Finomnis/GenericHardware/README.md

# GenericHardware
Generic Hardware Projects that didn't fit in anywhere else and were too small to get their own repository.
