Finomnis/GenericHardware/devboard-stm32g030f6p6/release/v1/devboard-stm32g030f6p6.pdf

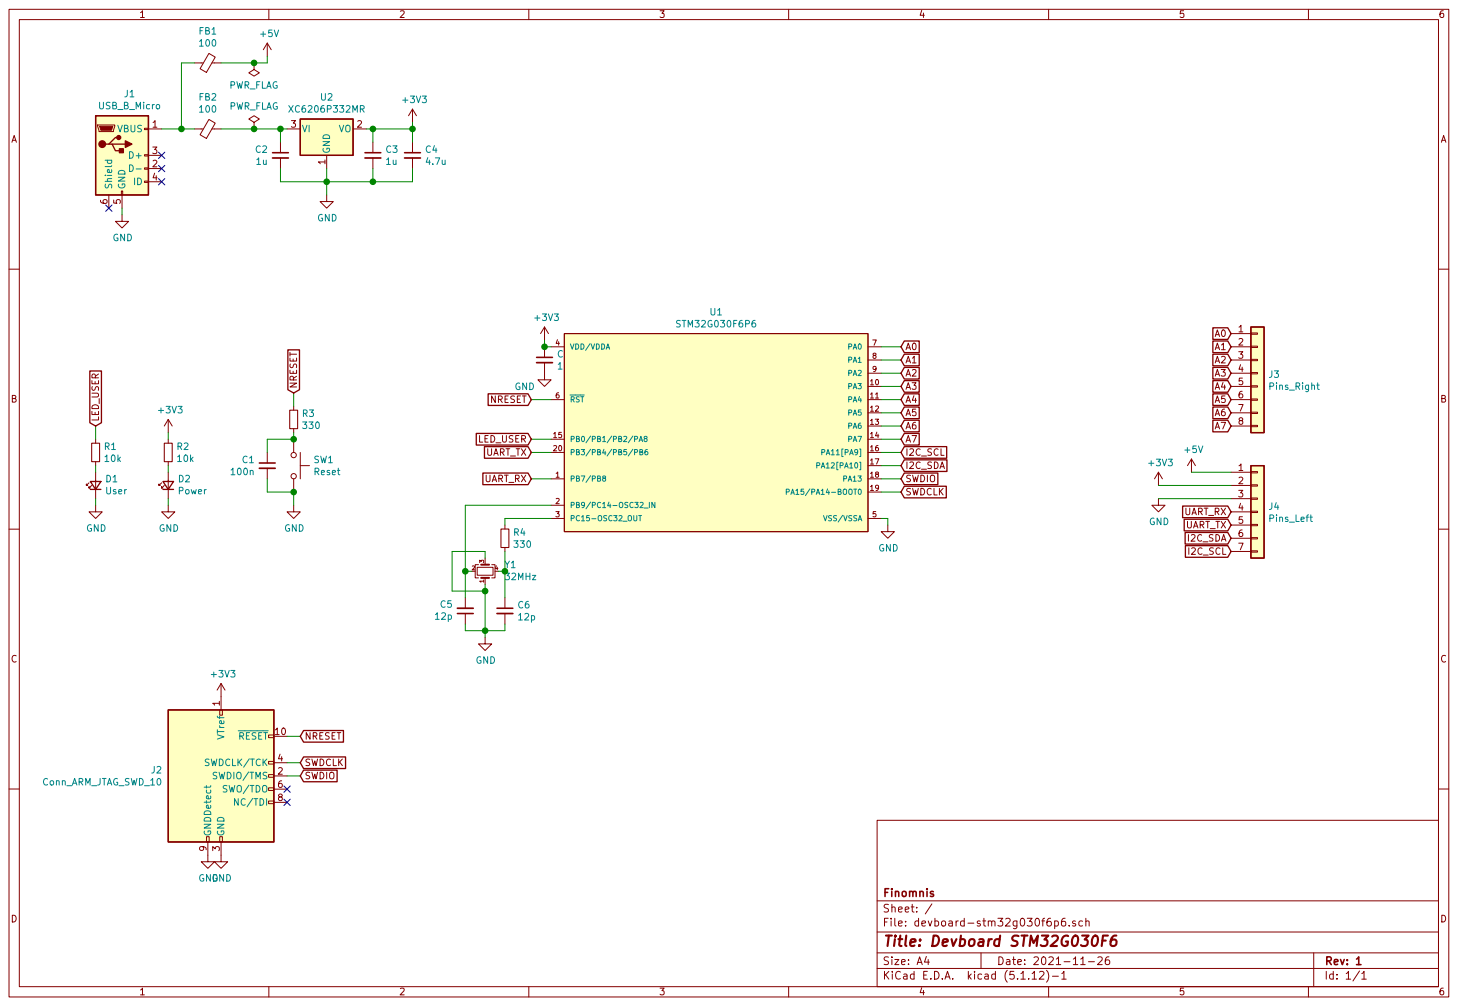
[picture p1: page 1]

File: devboard-stm32g030f6p6.sch Sheet: / Finomnis R4

3 SWDCLK/TCK 4 SWO/TDO 6 NC/TDI 8 GNDDetect 9
