Finomnis/GenericHardware/(commit log)

2021-11-11 Add stm32g030f6p6 devboard
    [devboard-stm32g030f6p6.kicad_pcb, devboard-stm32g030f6p6.sch]
2021-11-11 Fix shield connections for USB footprint
2021-11-11 Add board layout
    [devboard-stm32g030f6p6.kicad_pcb, devboard-stm32g030f6p6.sch]
2021-11-11 More layout work
    [devboard-stm32g030f6p6.kicad_pcb]
2021-11-11 Finish layout
    [devboard-stm32g030f6p6.kicad_pcb, devboard-stm32g030f6p6.sch]
2021-11-12 Fix usb not being marked SMD
    [devboard-stm32g030f6p6.kicad_pcb]
2021-11-12 Add release files
    [bom.csv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]
2021-11-12 Final version, sent to JLCPCB
    [bom.csv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]
2021-11-26 Add schematic pdf
    [devboard-stm32g030f6p6.sch]
2022-01-21 Fix oscillator being rotated by 90 degrees
    [devboard-stm32g030f6p6.kicad_pcb, devboard-stm32g030f6p6.sch]
2022-01-21 Reduce crystal bypass capacitors to 10p, frequency measures too low
    [devboard-stm32g030f6p6.sch]
2022-01-21 Update 10p caps in pcb
    [devboard-stm32g030f6p6.kicad_pcb]
2022-01-21 Increase via size to 0.25mm
    [devboard-stm32g030f6p6.kicad_pcb]
2022-01-21 Increase crystal bypass caps back up to 12p
    [devboard-stm32g030f6p6.kicad_pcb, devboard-stm32g030f6p6.sch]
